Maxnikit/test03/Максим_диплом/КурсачФевраль/СпецификацияА4.pdf

Форм. Зона Поз. Обозначение Наименование Кол. При-

меч.

Документация

### 1 Схема электрическая принци-

пиальная

Покупные элементы

2 | DD1 | GY-273 3V-5V HMC5883L | 1
3 | DD3 | GPS GY-GPSV3-NEO | 1
4 | DD4 | LoRa UART E32-433T30D | 1
5 | DD5, DD6 | LM2596 DC-DC | 2
6 | DD7 | TBS CROSSFIRE NANO RX | 1
7 | DD8, DD9 | L0577 | 2
8 | M1, M2 | BRS-775SH 12В | 2
9 | M3 | TD8120MG | 1

## Схема электрическая принципиальная

Изм | Лист | № докум. | Подп. | Дата
Разраб. | Никитин М.С. | | | | Лит. | Лист | Листов
Пров. | Майстришин М.М. | 1
каф. ПСАТП
гр. МР/б-20-1-о Н.контр.
Утв.
