Maxnikit/test03/Максим_диплом/Габаритный чертёж.png

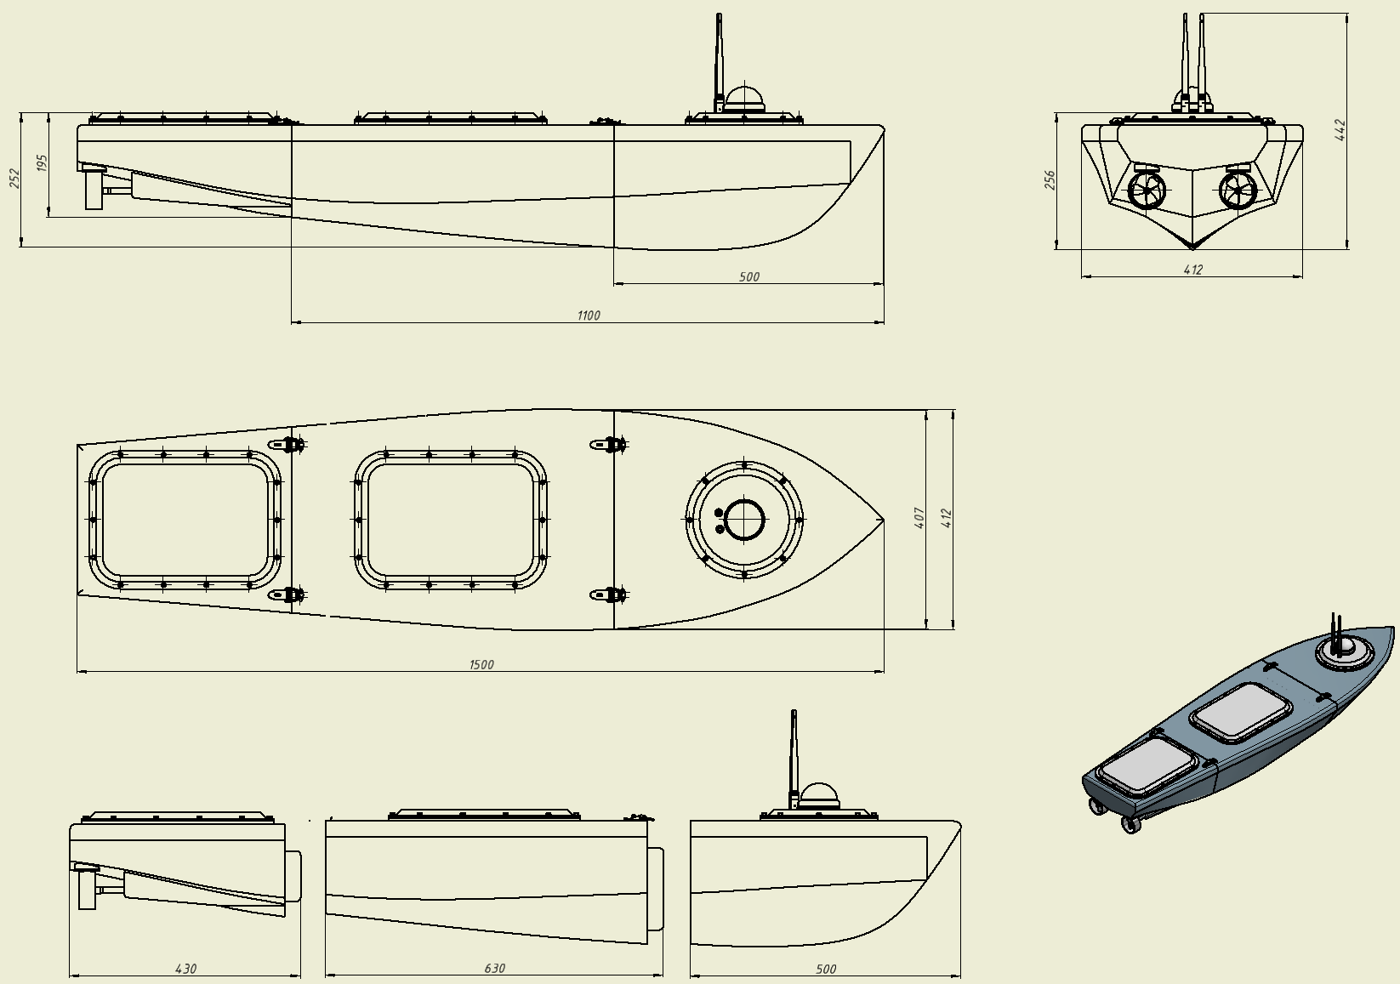
Максим_диплом/Габаритный чертёж.png
