Maxnikit/test03/(list of files, cad)

Other CAD files:
Максим_диплом/КурсачФевраль/Структурная Схема.dwg
Максим_диплом/СБ Валопровод.dwg
Максим_диплом/Габаритный чертёж.dwg
Максим_диплом/СБ Рулевая колонна.dwg
Максим_диплом/Общий вид.dwg
Максим_диплом/КурсачФевраль/OldVersions/Структурная Схема.0003.dwg
