Maxnikit/test03/Максим_диплом/Спецификация_Схема_электрическая.pdf

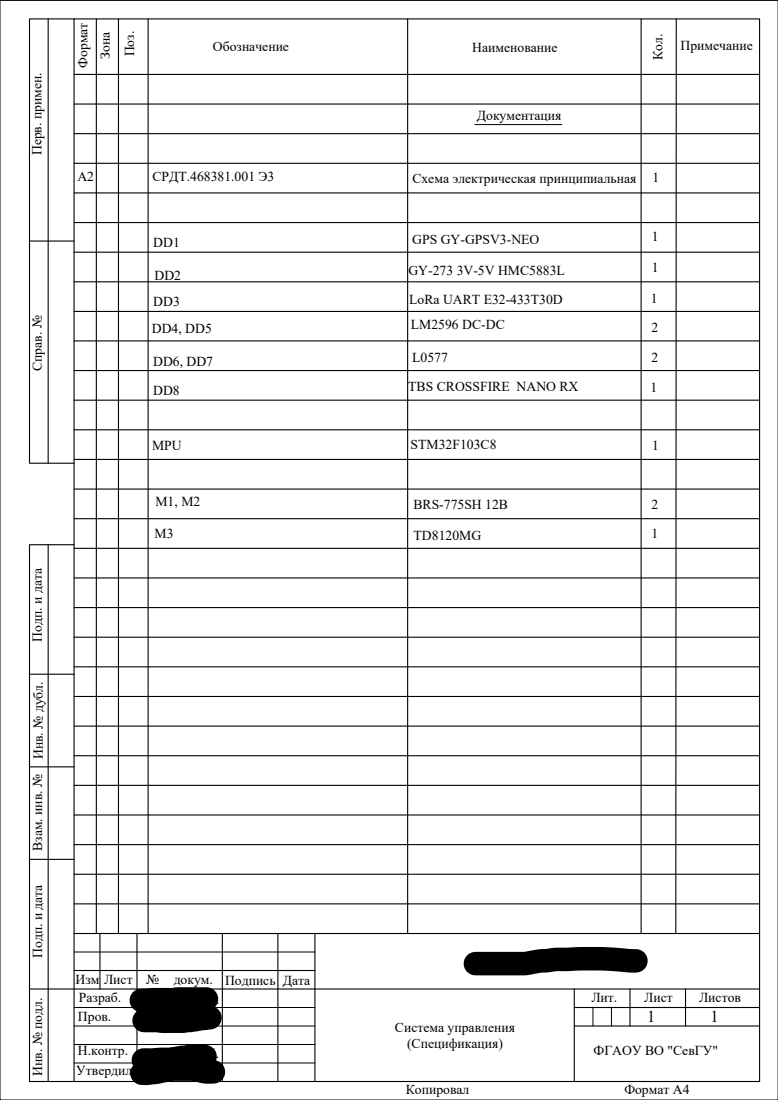
[picture p58: page 1]
Схема электрическая принципиальная; Система управления; (Спецификация); ФГАОУ ВО "СевГУ"; СРДТ.468381.001 Э3; Головин В.И.; Кабанов А.А.; Голяшов П.В.; Вожжов А.А. Поз.; Обозначение; Наименование Зона Формат; Лист; № докум.; Подпись; Дата; Копировал; Формат А4

Перв. примен. Кол. Примечание Справ. № Подп. и дата Инв. № дубл. Взам. инв. № Подп. и дата Инв. № подл. Пров.

DD1 | GPS GY-GPSV3-NEO | 1

DD2 | GY-273 3V-5V HMC5883L | 1

DD3 | LoRa UART E32-433T30D | 1

DD8 | TBS CROSSFIRE NANO RX | 1

M1, M2 | BRS-775SH 12В | 2
