Maxnikit/test03/Максим_диплом/Спецификация (Валопровод).pdf

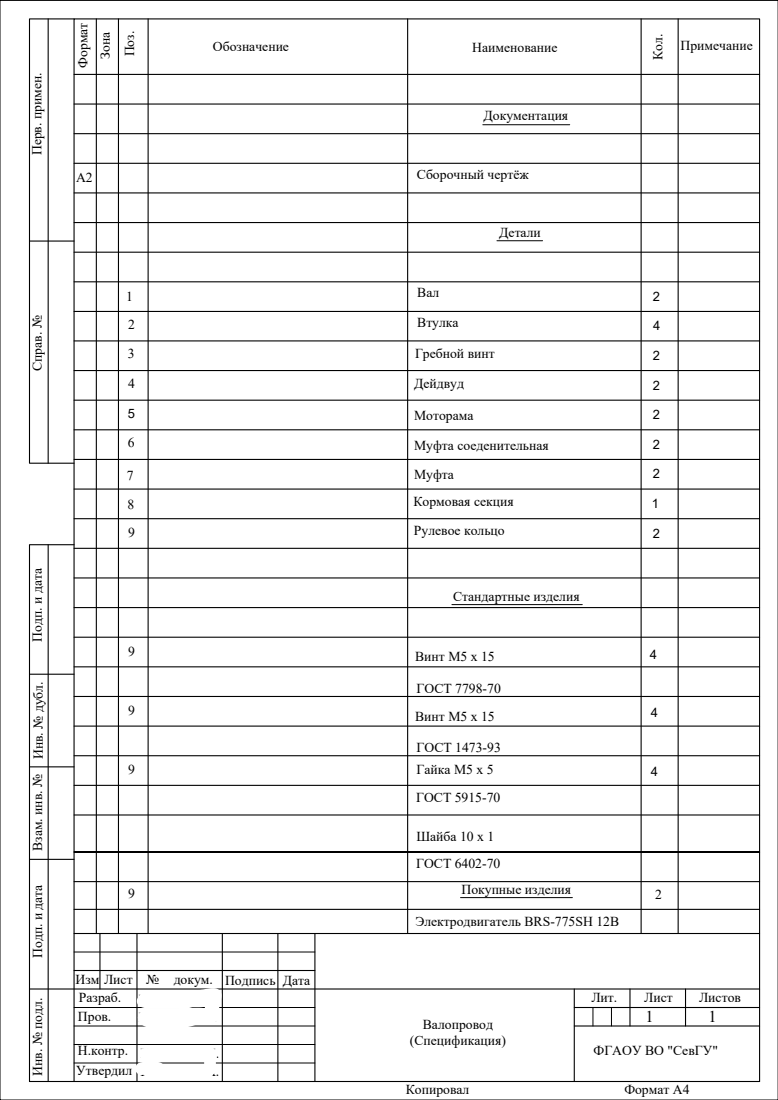
[picture p59: page 1]
Головин В.И.; Кабанов А.А.; Сборочный чертёж; Стандартные изделия; СРДТ.303739.001 СБ; Обозначение; Наименование Зона Формат; Лист; № докум.; Подпись; Дата; Копировал; Формат А4

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

3 | СРДТ.303739.001 Поз. Гребной винт | 2

1 | Вал | 2

2 | Втулка | 4

4 | Дейдвуд | 2

5 | Моторама | 2

6 | Муфта соеденительная | 2

7 | Муфта | 2

8 | Кормовая секция | 1

9 | Рулевое кольцо | 2

9 | Винт М5 х 15 | 4

ГОСТ 7798-70

ГОСТ 1473-93

9 | Гайка М5 х 5 | 4

ГОСТ 5915-70

Шайба 10 х 1

ГОСТ 6402-70

9 | Покупные изделия | 2

Электродвигатель BRS-775SH 12В

Разраб. | Голяшов П.В. | Валопровод (Спецификация) | Лит. | Лист | Листов

Вожжов А.А. | | | | | 1 | 1

ФГАОУ ВО "СевГУ"
