Maxnikit/test03/Максим_диплом/Спецификация_Рулевая_колонна_лист_1.pdf

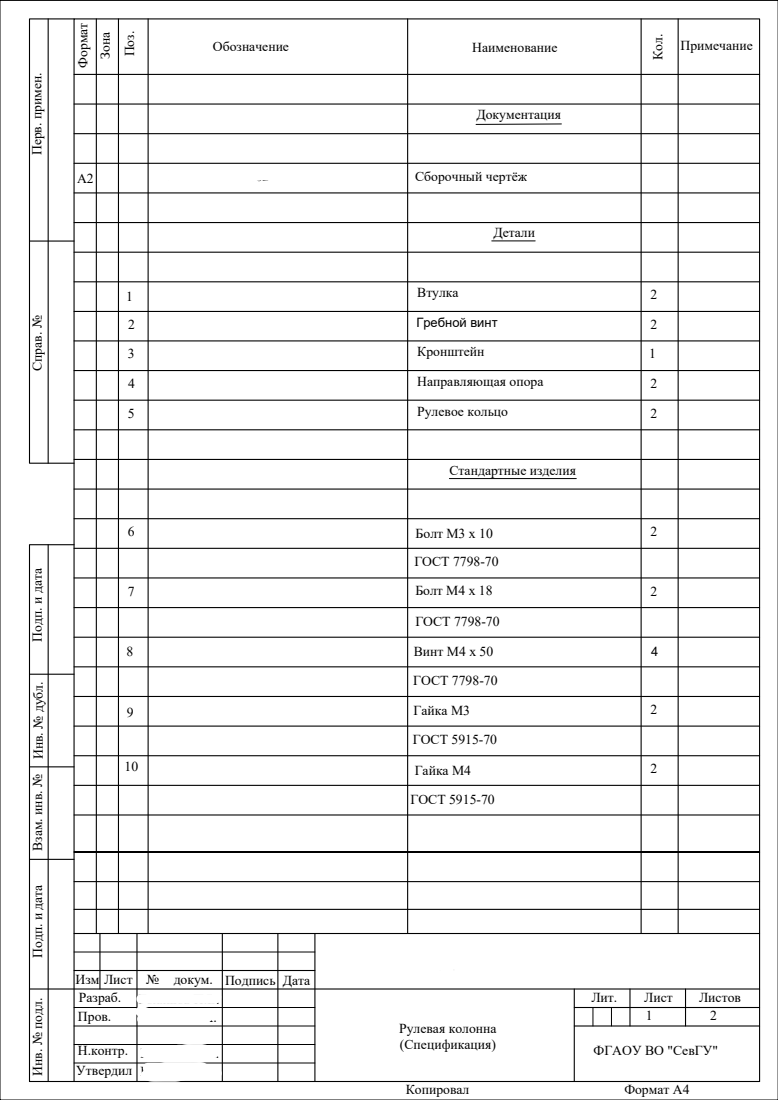
[picture p60: page 1]
Головин В.И.; Кабанов А.А.; Сборочный чертёж; Стандартные изделия; СРДТ.303739.002 СБ; Обозначение; Наименование Зона Формат; Лист; № докум.; Подпись; Дата; Копировал; Формат А4

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

3 | СРДТ.303739.002 Поз. Кронштейн | 1

1 | Втулка | 2

2 | Гребной винт | 2

4 | Направляющая опора | 2

5 | Рулевое кольцо | 2

6 | Болт М3 х 10 | 2

ГОСТ 7798-70

7 | Болт М4 х 18 | 2

8 | Винт М4 х 50 | 4

9 | Гайка М3 | 2

ГОСТ 5915-70

10 | Гайка М4 | 2

Разраб. | Голяшов П.В. | Рулевая колонна (Спецификация) | Лит. | Лист | Листов

Вожжов А.А. | | | | | 1 | 2

ФГАОУ ВО "СевГУ"
