Maxnikit/test03/Максим_диплом/Спецификация_Рулевая_колонна_лист_2.pdf

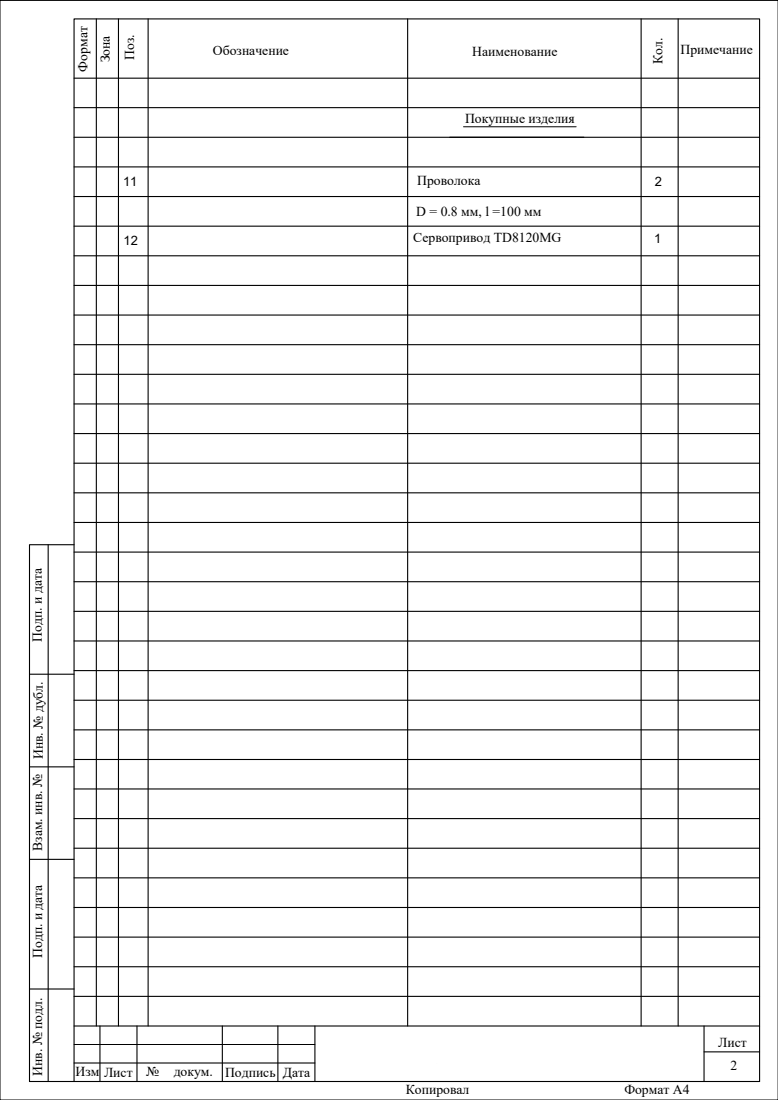
[picture p61: page 1]
Покупные изделия; Сервопривод TD8120MG; Изм; Лист; № докум.; Подпись; Дата; Копировал; Формат А4 Подп. и дата Инв. № дубл. Взам. инв. № Подп. и дата Инв. № подл.; Лист Поз.; Обозначение; Наименование Зона Формат; Кол.; Примечание
