Maxnikit/test03/Максим_диплом/Спецификация_Чертёж_общего_вида.pdf

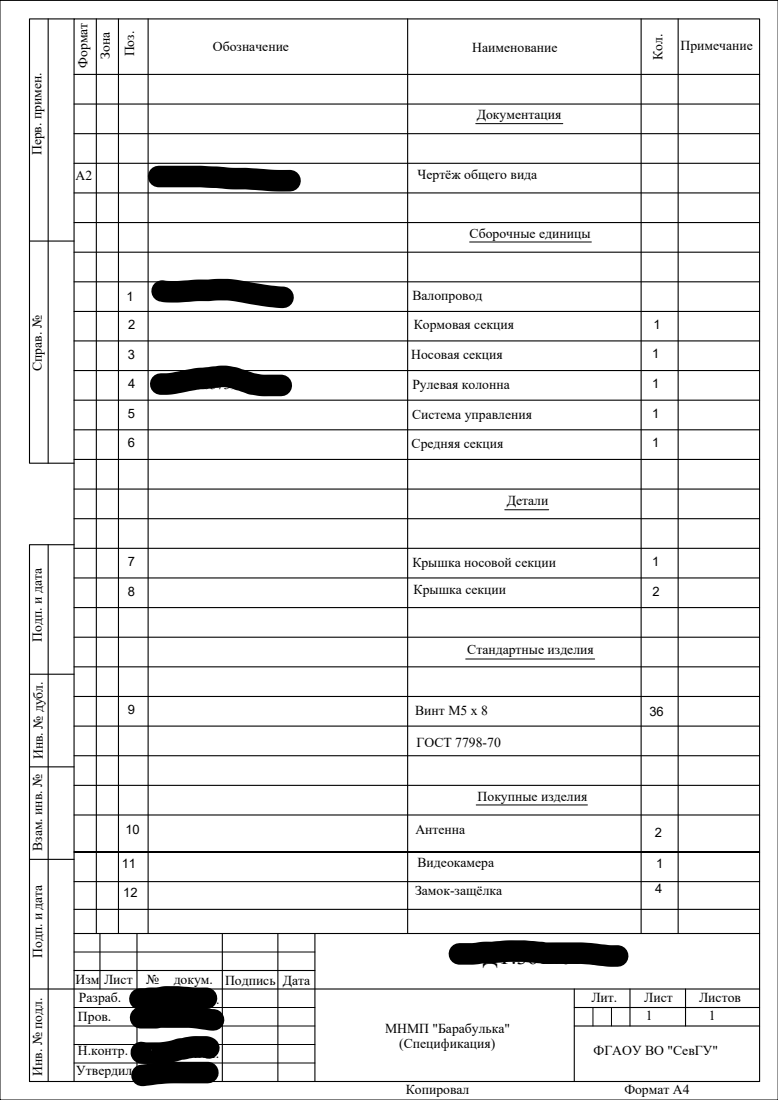
[picture p62: page 1]
Головин В.И.; Кабанов А.А.; Сборочные единицы; Стандартные изделия; СРДТ.361461.001 ВО; Обозначение; Наименование Зона Формат; Лист; № докум.; Подпись; Дата; Копировал; Формат А4

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

СРДТ.303739.002 СБ Поз.

Документация

Чертёж общего вида

1 | СРДТ.303739.001 СБ | Валопровод

2 | | Кормовая секция | 1

3 | | Носовая секция | 1

4 | | Рулевая колонна | 1

5 | | Система управления | 1

6 | | Средняя секция | 1

7 | Крышка носовой секции | 1

8 | Крышка секции | 2

9 | Винт М5 х 8 | 36

ГОСТ 7798-70

Покупные изделия

10 | Антенна | 2

11 | Видеокамера | 1

12 | Замок-защёлка | 4

СРДТ.361461.001

Разраб. | Голяшов П.В. | | МНМП "Барабулька" (Спецификация) | Лит. | Лист | Листов

Вожжов А.А. | | | | | | 1 | 1

ФГАОУ ВО "СевГУ"
