Maxnikit/test03/Максим_диплом/КурсачФевраль/Общий видА1.pdf

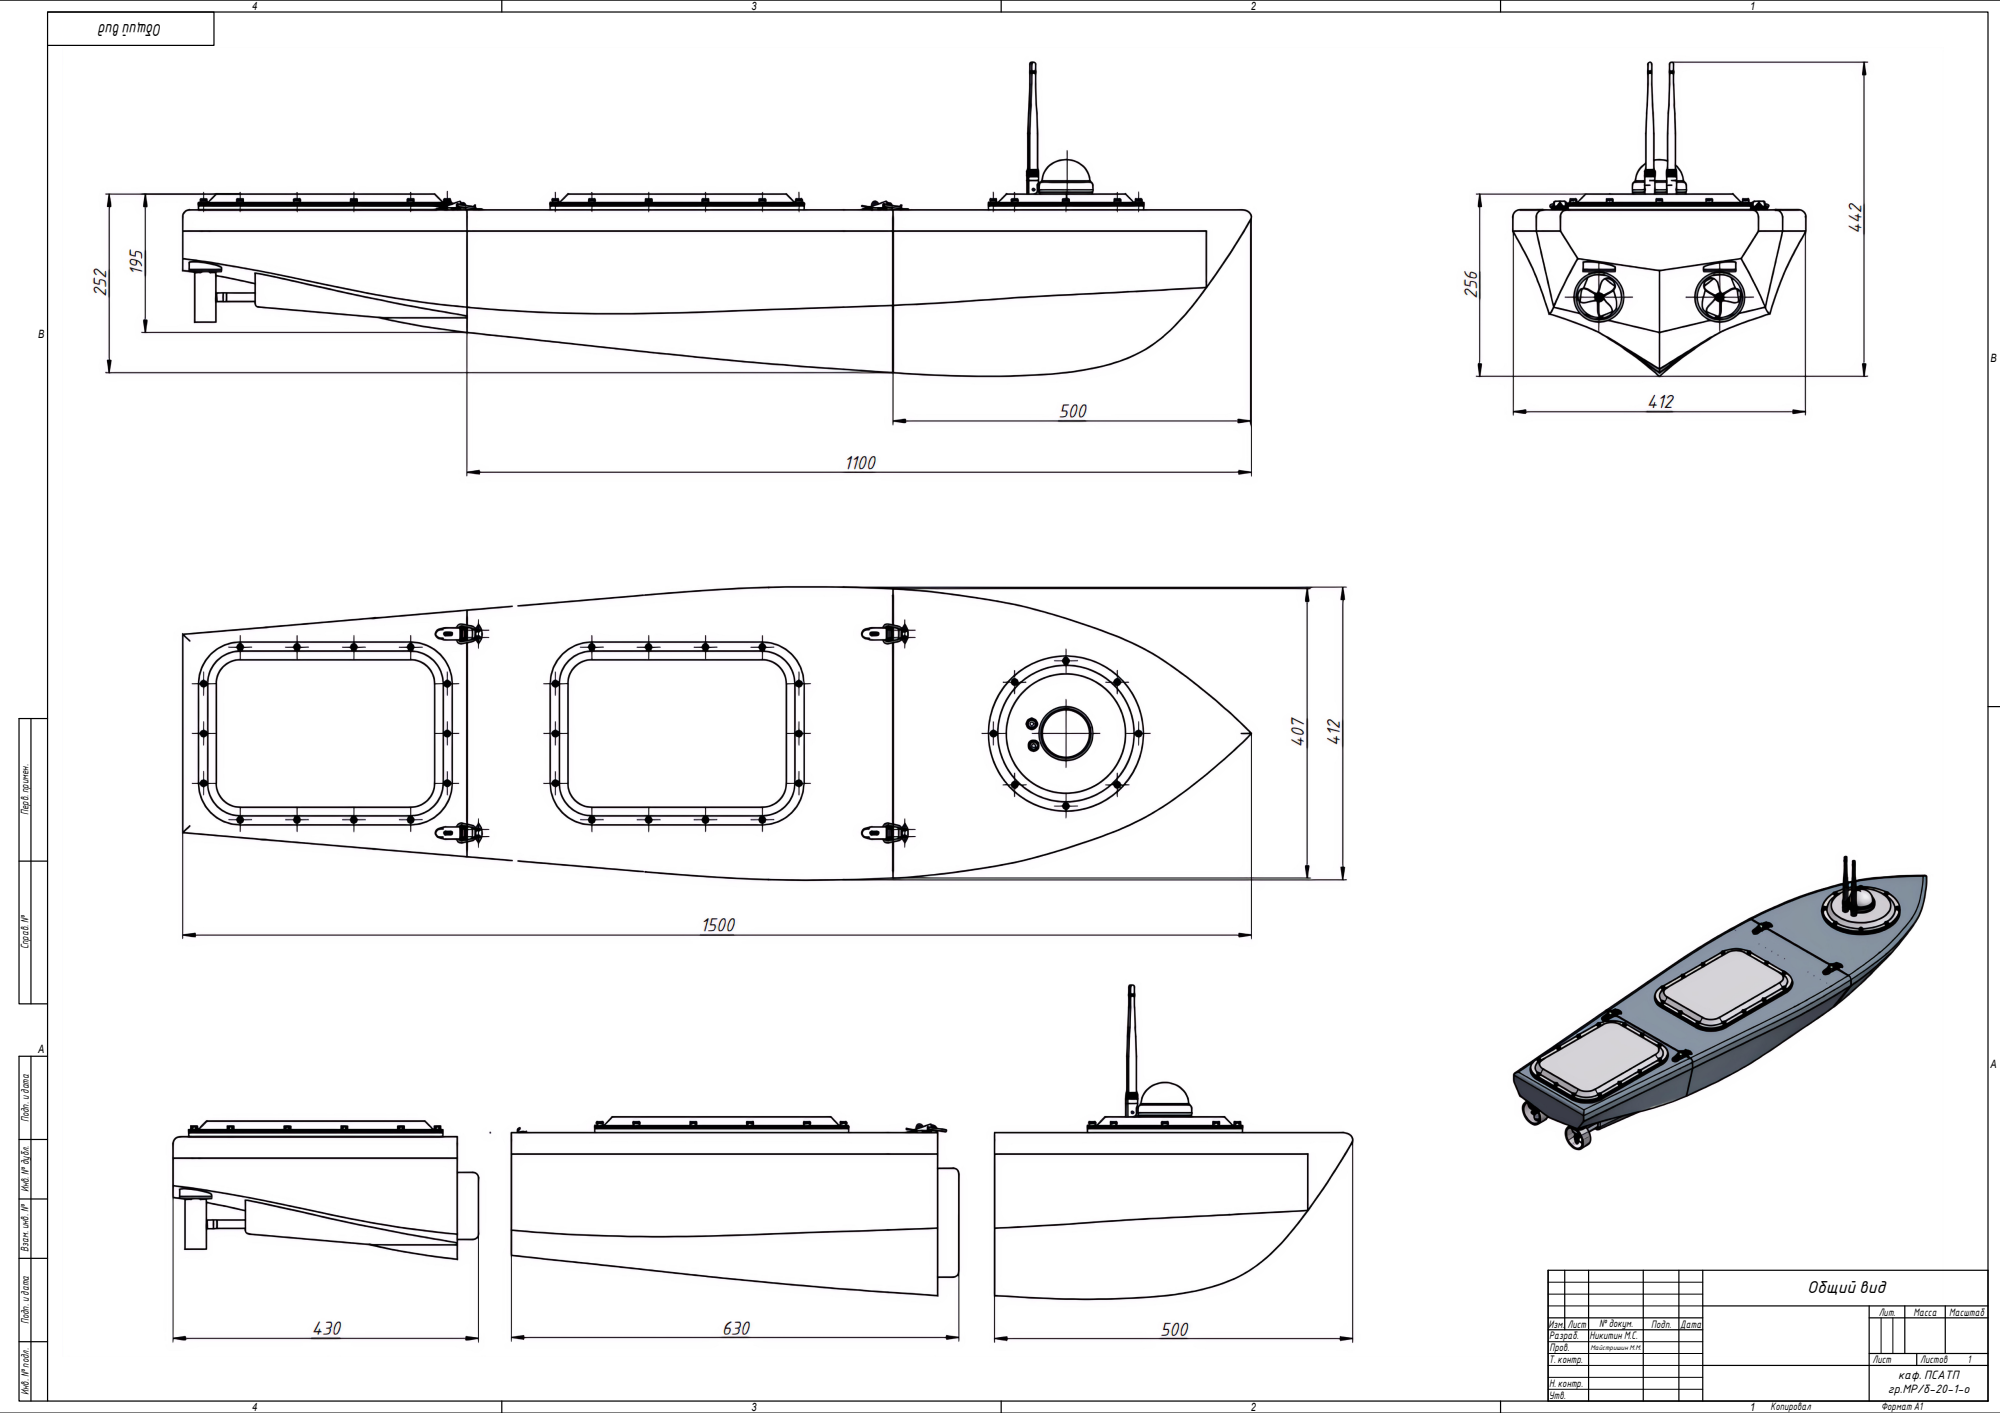
[picture p63: page 1]
б. Пров. Т. контр. Н. контр. Утв.

Инв. № подл. Подп. и дата Взам. инв. № Инв. № дубл. Подп. и дата Справ. № Перв. примен.

И з м. | Л и с т | № д о к у м. | П о д п. | Д а т а
Р а з р а | | Н и к и т и н

Л и с т | Л и с т о в 1
к а ф. П СА ТП гр.МР / б -2 0 -1 -о
