Maxnikit/test03/Максим_диплом/КурсачФевраль/Структурная СхемаА2.pdf

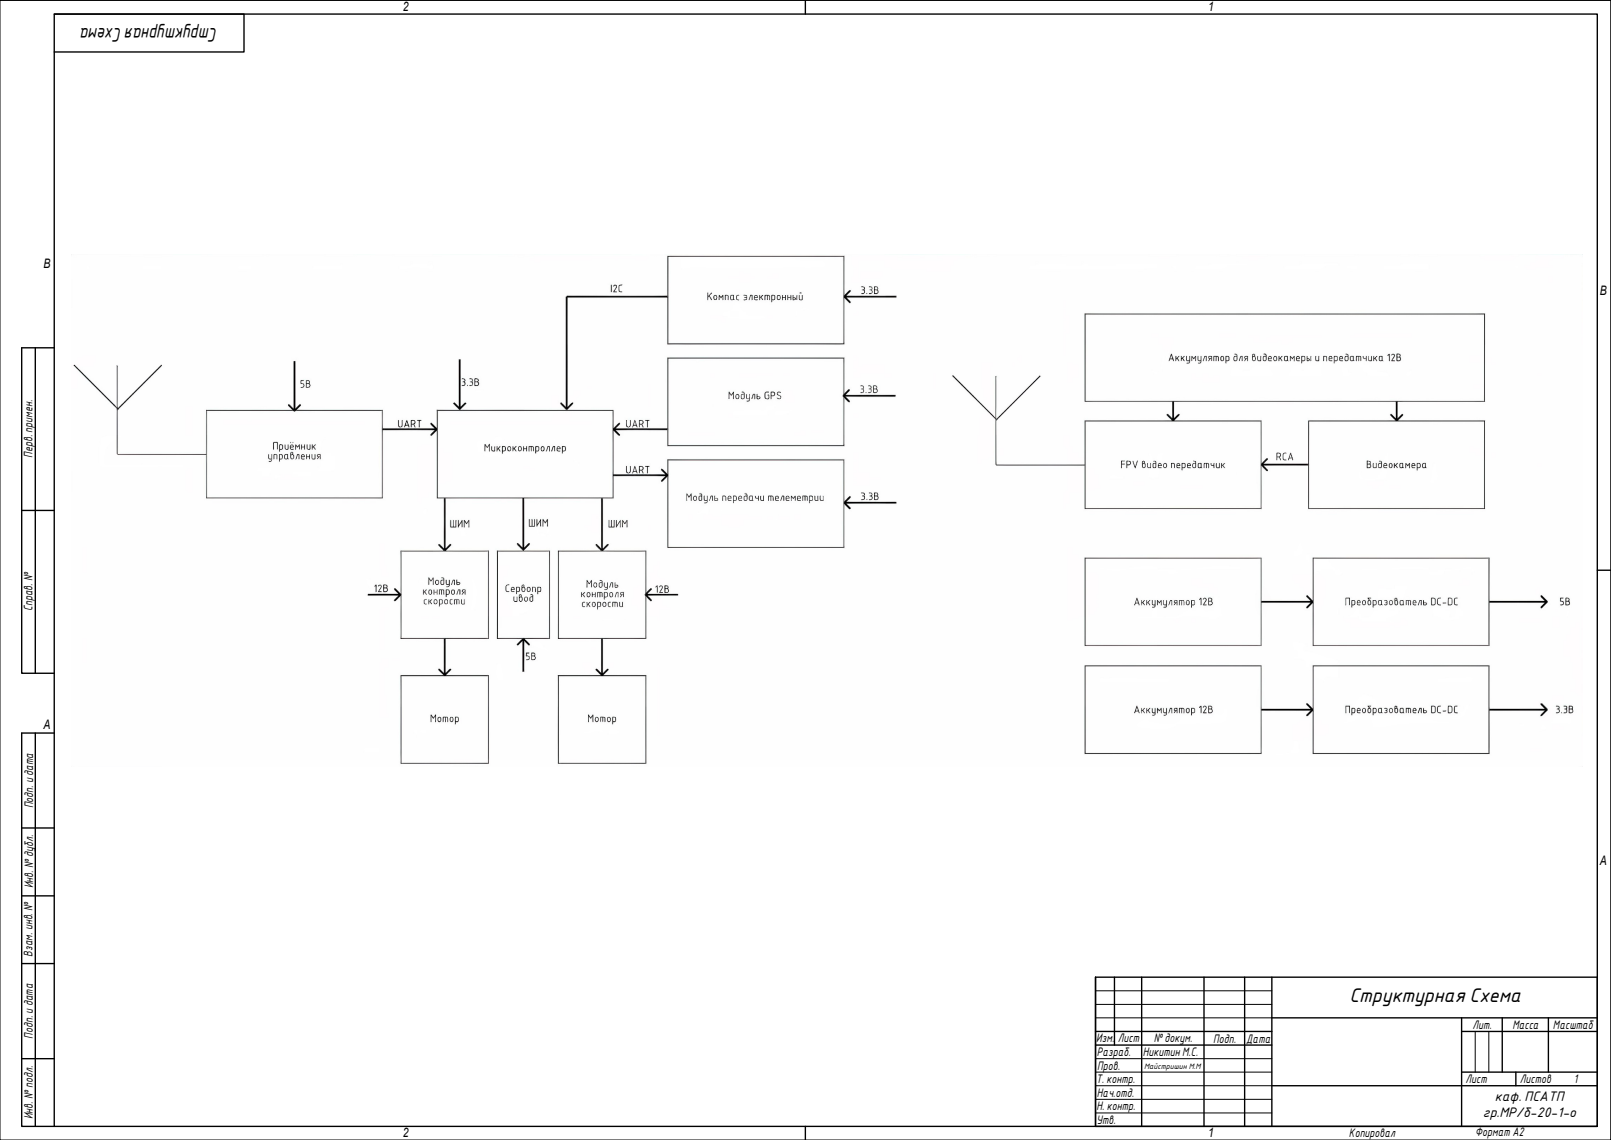
[picture p64: page 1]
б. Пров. Т. контр. Н. контр. Утв.

Инв. № подл. Подп. и дата Взам. инв. № Инв. № дубл. Подп. и дата Справ. № Перв. примен.

Из м. | Л и с т | № д о к у м. | П о д п. | Д а т а
Р а з р а | | и к и т и н
