Maxnikit/test03/Максим_диплом/КурсачФевраль/Схема_электрическая_принципиальнаяА2.pdf

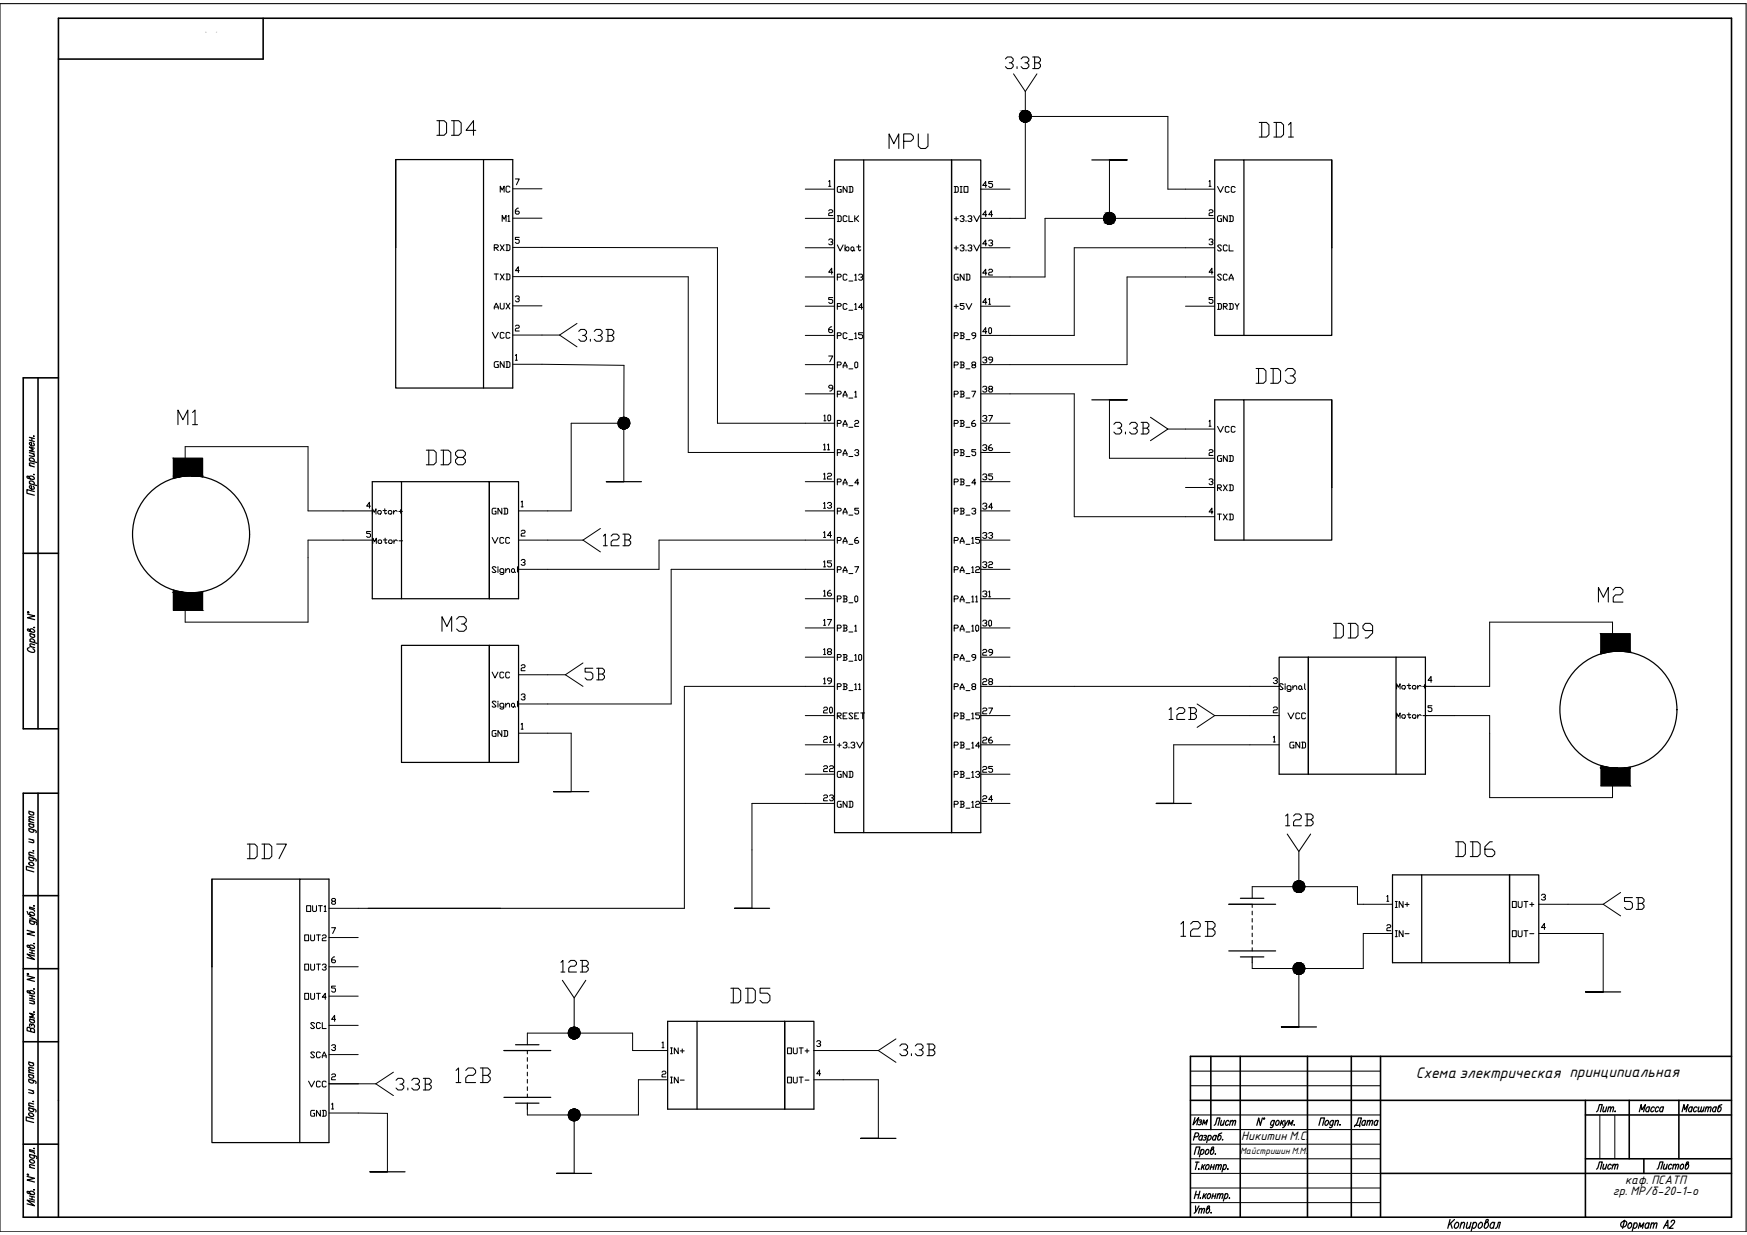
[picture p65: page 1]
каф. ПСАТП гр. МР/б-20-1-о

Схема электрическая принципиальная

Никитин М.С.

Майстришин М.М.
