Maxnikit/test03/Максим_диплом/КурсачФевраль/Печать/А2/Структурная СхемаА2.pdf

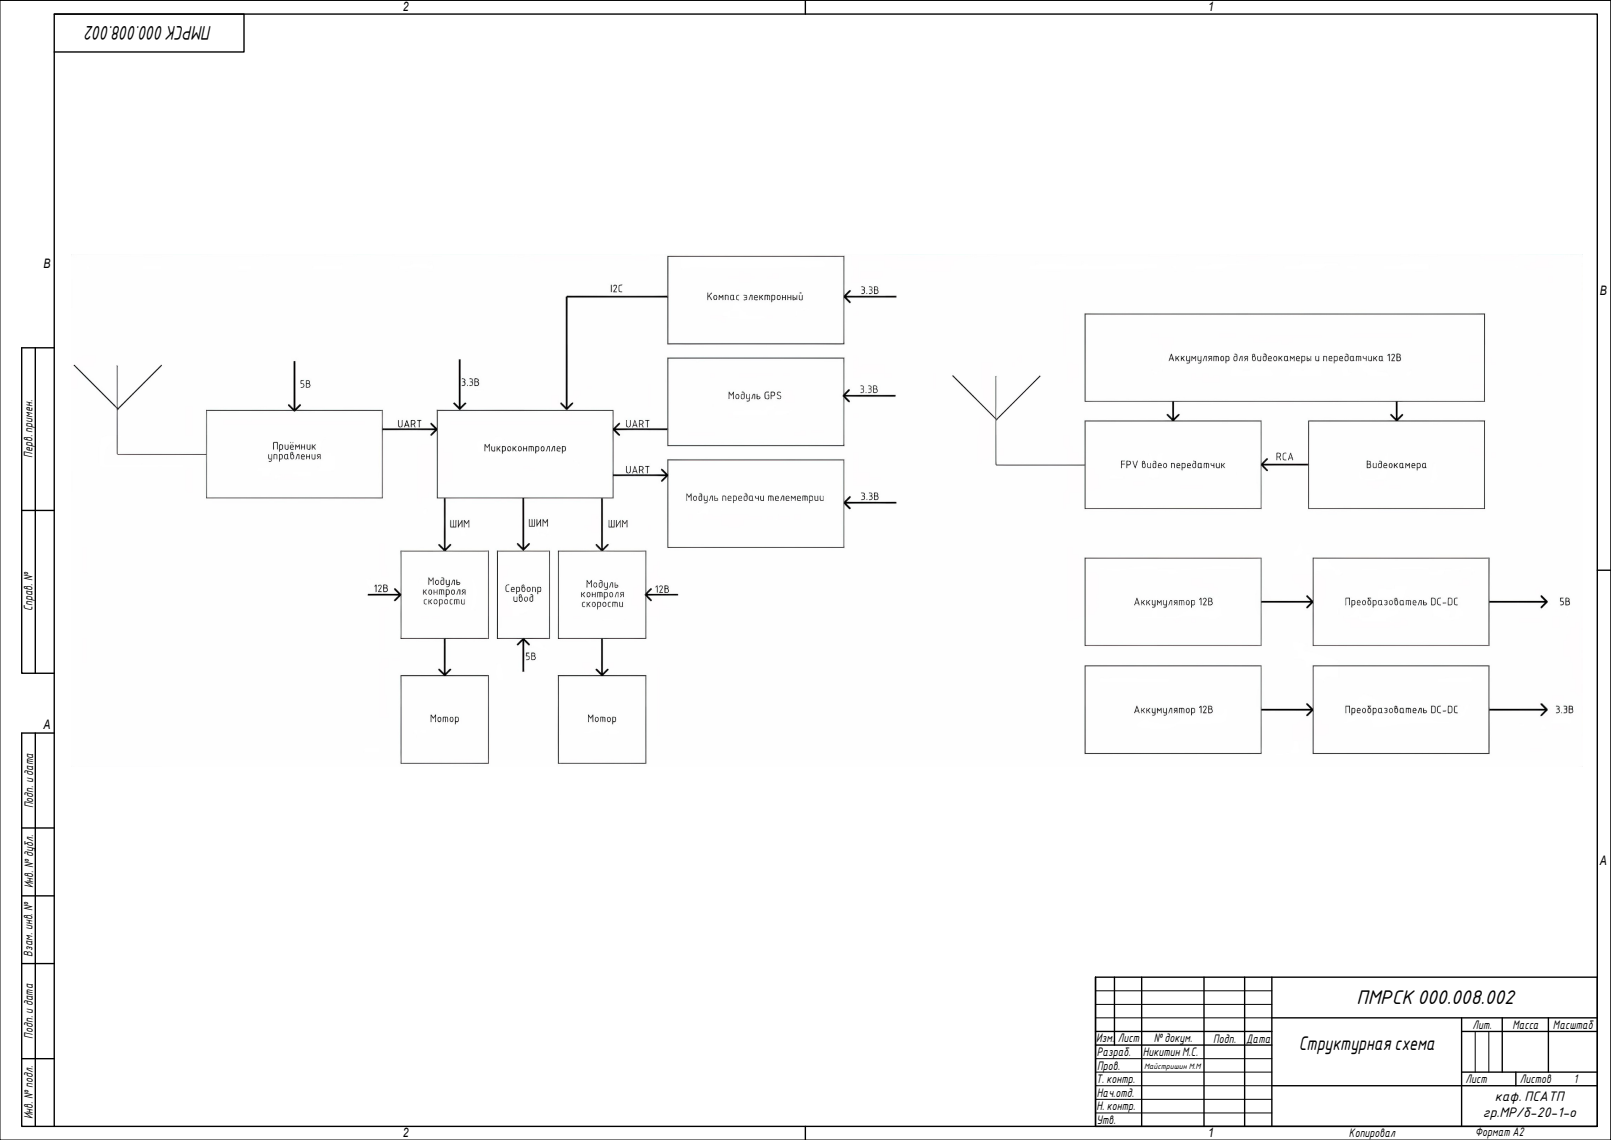
[picture p66: page 1]
Формат A2; Инв. №; л. Под; бл. Под; Перв. п

ПМРСК 000.008.002

Структурная схема | Лит. | Масса | Масштаб

Изм. | Лист | № докум. | Подп. | Дата
Разраб. | | Никитин М.С.
Пров. | | Майстришин М.М
Т. контр. | | | | | Лист | Листов 1
Нач.отд. | | | | | каф. ПСАТП гр.МР/б-20-1-о
Н. контр.
Утв.
