Maxnikit/test03/Максим_диплом/КурсачФевраль/Печать/А2/Схема_электрическая_принципиальнаяА2.pdf

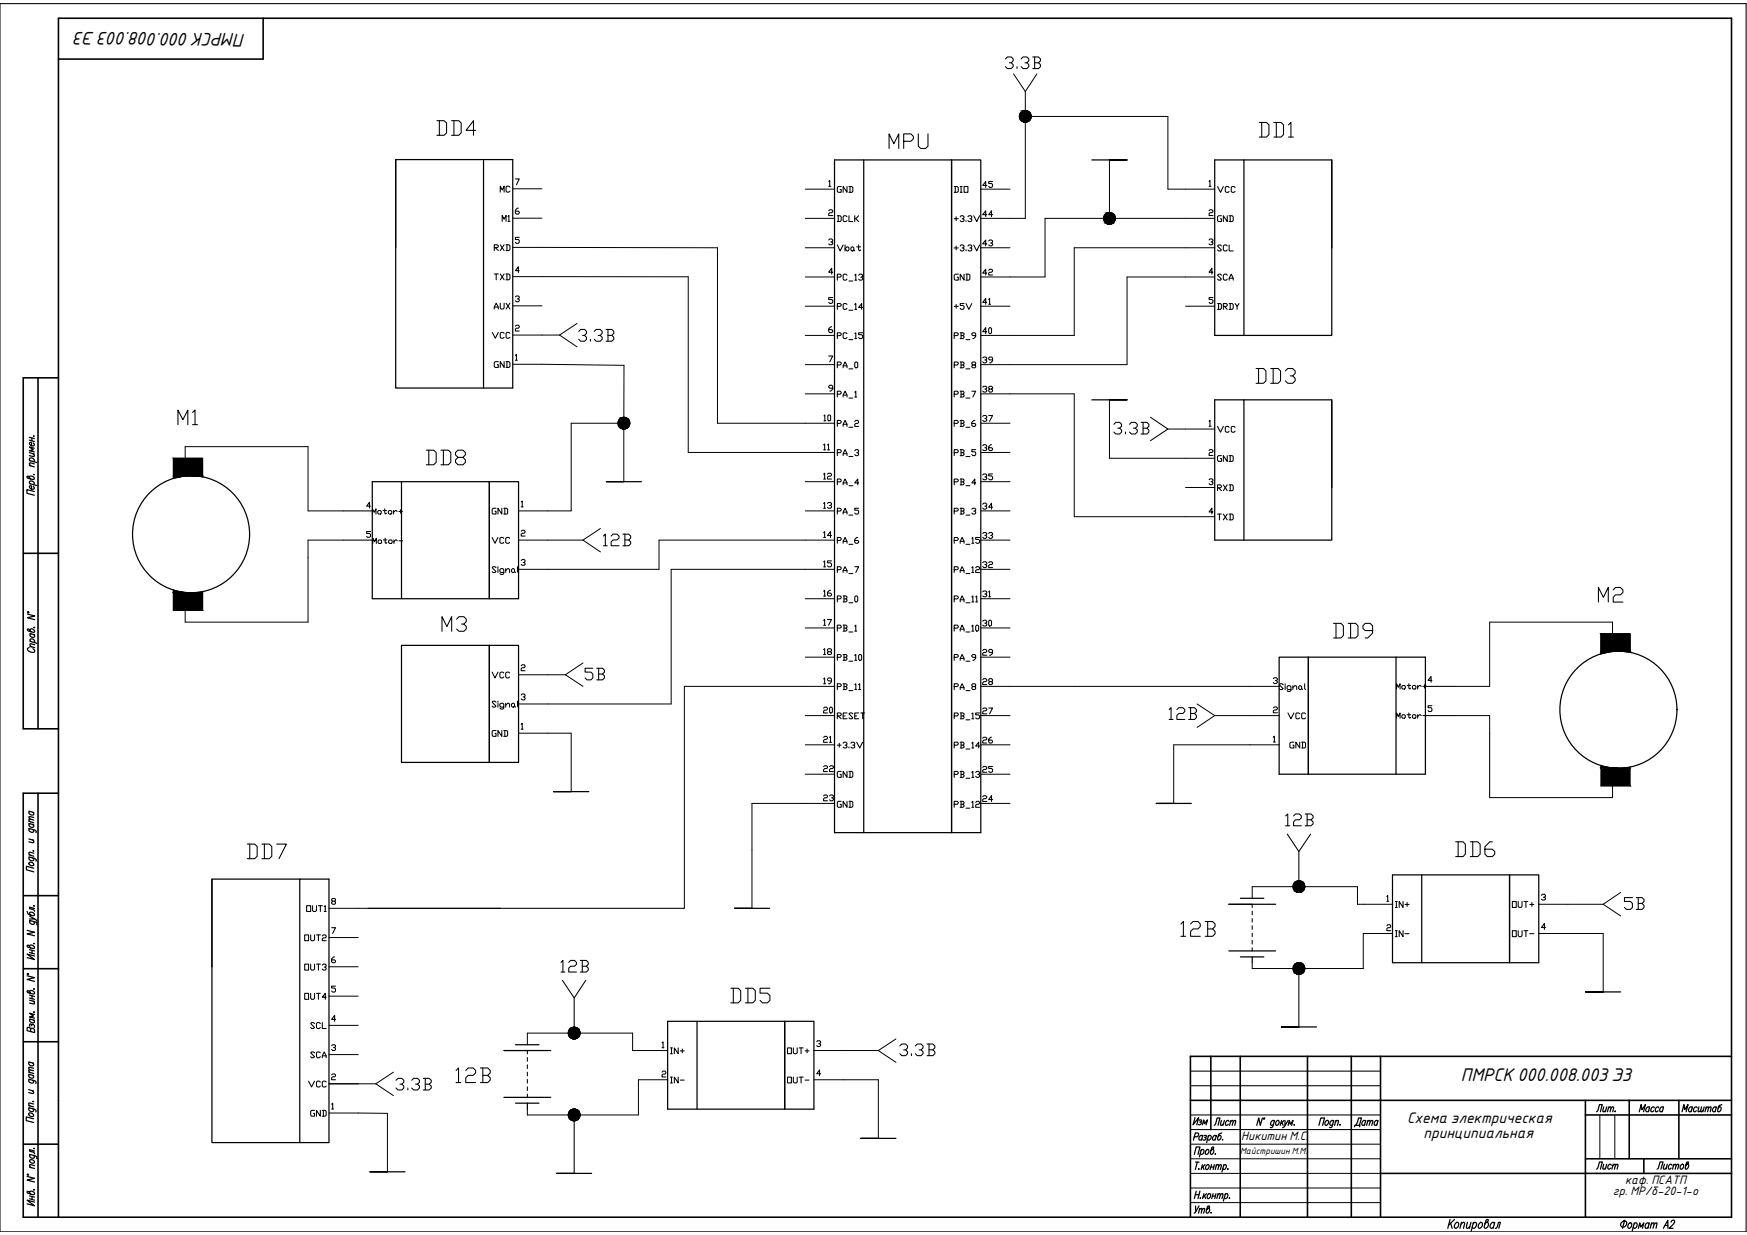
[picture p67: page 1]
каф. ПСАТП гр. МР/б-20-1-о; Схема электрическая; ПМРСК 000.008.003 Э3

Никитин М.С.

Майстришин М.М.
